jagathsrujan/pj45-pulsejet/cad/PJ-4.5_head-detail.png

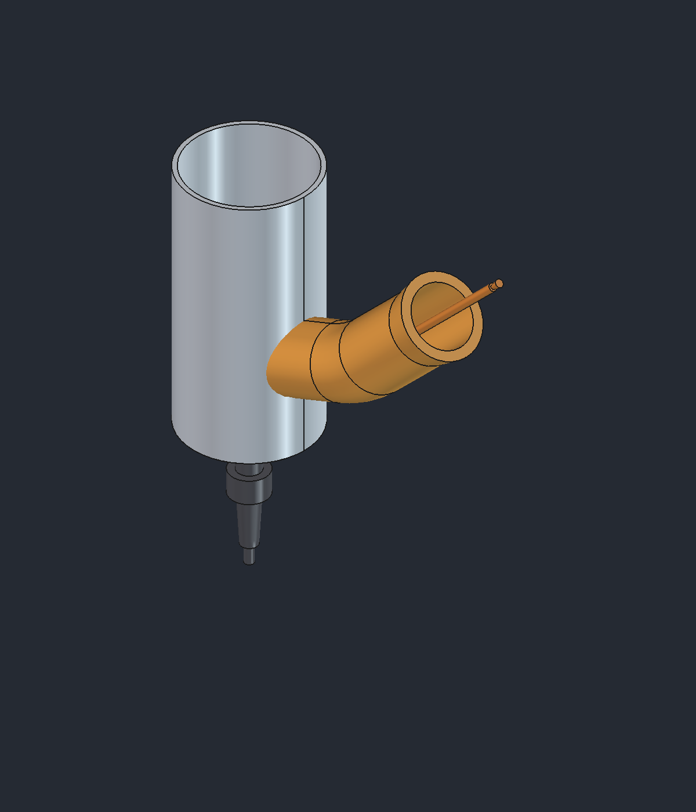
cad/PJ-4.5_head-detail.png
