jagathsrujan/pj45-pulsejet/cad/PJ-4.5_iso.png

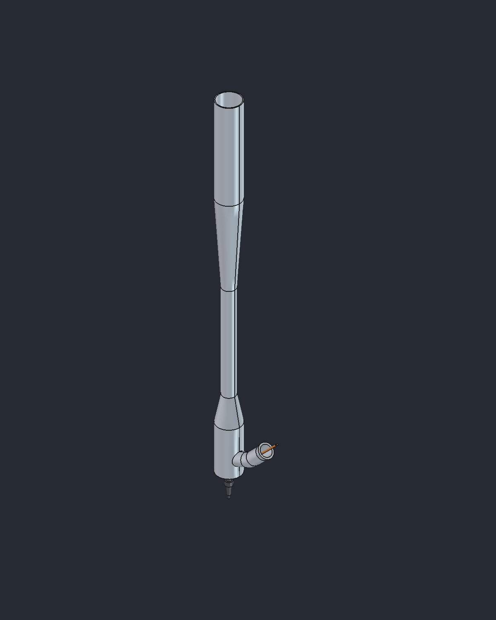
cad/PJ-4.5_iso.png
