jagathsrujan/pj45-pulsejet/cad/PJ-4.5_section-rear.png

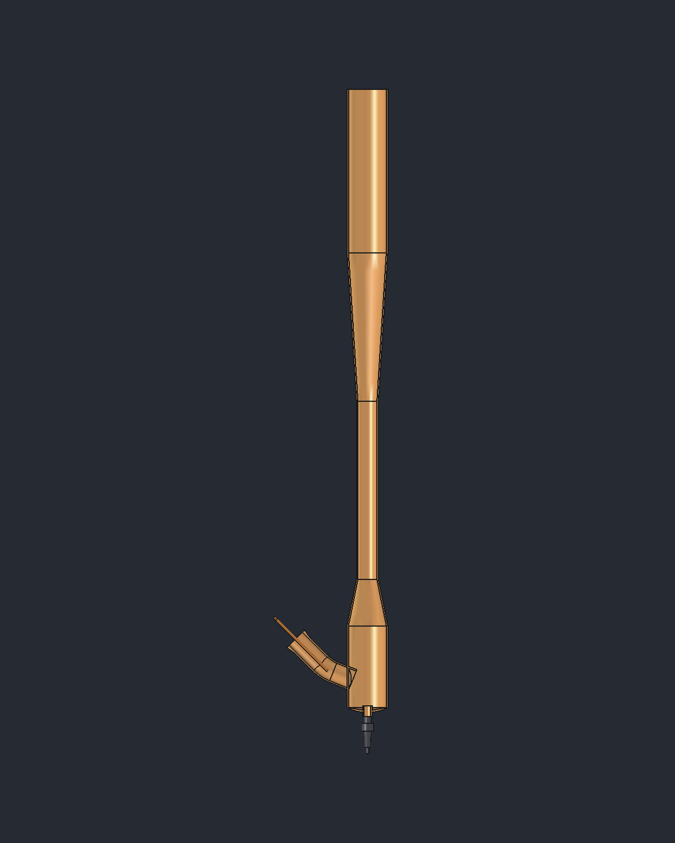
cad/PJ-4.5_section-rear.png
