jagathsrujan/pj45-pulsejet/cad/PJ-4.5_side.png

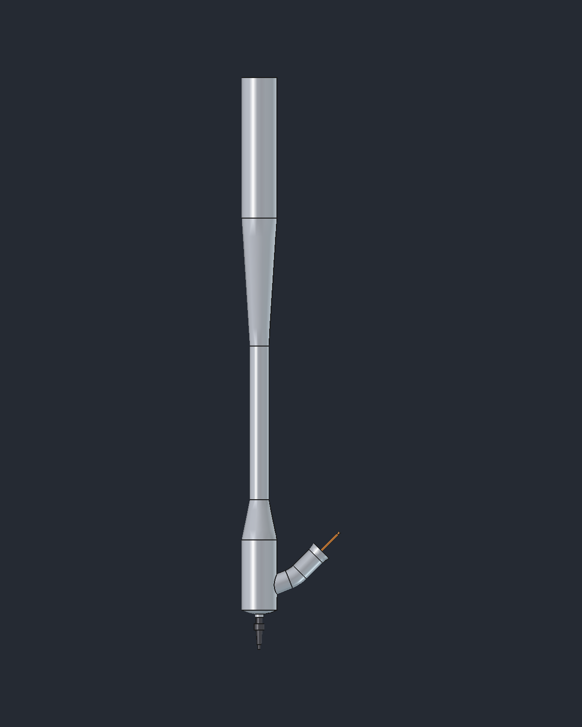
cad/PJ-4.5_side.png
