jagathsrujan/pj45-pulsejet/build/BOM-INDIA.md

# PJ-4.5 Pulse Jet — Bill of Materials (India) — **Hybrid Build**

**Configuration:** reusable metal hot sections + reprintable printed cones/intake, **zero welding** (threaded pipe stack + printed couplers).
**Guides:** `printed-test/HYBRID-TEST-GUIDE.md` (assembly + shopping list) · `cad/CAD-NOTES.md` (geometry) · STLs in `printed-test/HJ_01…05`.
**Currency:** ₹ INR · indicative prices checked Oct 2026 · verify locally (±30%) · 🟢 core · 🟡 to run · ⚪ recommended

---

## A. Engine — metal sections (reusable forever, no welding) 🟢

| # | Item | Spec | Qty | Est. ₹ | Where |
|---|---|---|---|---|---|
| A1 | Chamber tube | 2″ BSP SS304 threaded pipe nipple, 150 mm (2″×6″) | 1 | 300–500 | local pipe/plumbing market |
| A2 | Chamber head | 2″ BSP SS304 coupling (socket) | 1 | 200–300 | same |
| A3 | Head bushing | 2″×½″ BSP SS304 hex reducing bushing | 1 | 120–200 | same |
| A4 | **Plug boss** | ½″ BSP SS304 hex plug — drill Ø9, tap M10×1 | 1 | 80–150 | same (uses tap I2) |
| A5 | Centre pipe | Ø30×1.5 mm SS304 tube, ~245 mm | 1 | 150–250 | steel market |
| A6 | Exhaust pipe | 2″ NB SS304 pipe Sch-10S (Sch-5S ok), ~220 mm | 1 | 250–400 | steel market offcut |
| A7 | Copper washers | ½″ + M10 sizes | 4 | ~30 | hardware |
| | **Subtotal A** | | | **~₹1,150–1,850** | reusable |

*Buy BSP (Indian standard) thread fittings in SS304 and test-fit threads at the shop. Alternative head: 2″ SS cap + Ø9.5 drill + M10×1 tap + thin M10×1 jam nut inside.*

## B. Engine — printed sections (consumables) 🟢

| # | Item | Spec | Qty | Est. ₹ | Where |
|---|---|---|---|---|---|
| B1 | Filament — working | **Numakers/WOL3D ABS ~₹710–900/kg** (budget) or **eSun ASA ~₹1,950/kg** (better) | 1 kg | 710–1,950 | ideal3d.in, Zbotic, Amazon.in |
| B2 | Filament — mockup | PLA 1 kg (fit-check prints first) | 1 | ~700 | Amazon.in |
| B3 | Printed set | `HJ_01` nozzle cone · `HJ_02` exhaust cone · `HJ_03` intake · `HJ_04` C1 couplers ×2 · `HJ_05` C2 couplers ×2 | 1 set | — | free STLs (print yourself, H2D) |
| | **Subtotal B** | | | **~₹1,400–2,650** | covers many reprints |

**Full set = 220 g** → **₹160 (ABS) / ₹430 (ASA) per reprint** — your only recurring cost.

## C. Assembly & sealing consumables 🟢

| # | Item | Spec | Qty | Est. ₹ | Where |
|---|---|---|---|---|---|
| C1 | Furnace/ceramic cement | 1000 °C+ class (not epoxy/RTV) | 1 kg | 150–350 | hardware / IndiaMART (refractory supplier) |
| C2 | Sodium silicate (water-glass) | bore coating for printed cones | 500 ml | ~100 | hardware/chemical shop |
| C3 | Ceramic fiber (kaowool) tape or blanket | wrap nozzle cone | 1 roll/small piece | 300–500 | IndiaMART / refractory shop |
| C4 | Fiberglass tape | 25 mm, intake root wrap | 1 roll | 100–150 | hardware |
| C5 | M3×8 self-tapping screws + washers | couple joints (pilot holes are printed in) | 20 | ~80 | hardware |
| C6 | PTFE tape + wire brush + sandpaper | thread sealing / cleanup | 1 set | ~80 | hardware |
| | **Subtotal C** | | | **~₹800–1,250** | |

## D. Fuel system (propane) 🟡

| # | Item | Spec | Qty | Est. ₹ | Where |
|---|---|---|---|---|---|
| D1 | LPG cylinder | 14.2 kg domestic (refill) or 5 kg | 1 refill | 600–900 | local gas agency |
| D2 | High-pressure LPG hose | steel-wire braided, 1.5–2 m | 1 | ~345 | Amazon.in / gas shop |
| D3 | Cylinder→hose adapter (no regulator) | brass burner-pipe adapter | 1 | 250–500 | gas/burner shop |
| D4 | **Needle valve (metering)** | brass ¼″ BSP, gas-rated | 1 | 400–1,200 | Amazon.in / IndiaMART |
| D5 | **Ball valve (kill switch)** | brass ¼″ gas ball valve | 1 | 150–400 | hardware / Amazon |
| D6 | Tee + nipples + hose clamps | brass ¼″, 4 clamps | 1 set | ~250 | hardware |
| D7 | Injector tube | 1/8″ (3.2 mm) copper/SS tube, ~300 mm ×2 | 2 | ~150 | refrigeration/AC spares shop |
| | **Subtotal D** | | | **~₹1,500–3,000** | |

## E. Ignition 🟡

| # | Item | Spec | Qty | Est. ₹ | Where |
|---|---|---|---|---|---|
| E1 | Spark plug | NGK CM-6 (M10×1) | 1 | 1,699 (Fortune India) | drone/RC shops, Amazon.in |
| E1′ | *(budget alt)* | generic M10×1 RC plug | 1 | 400–800 | Amazon.in |
| E2 | HT lead + plug cap | copper-core + silicone boot | 1 | ~200 | auto-electrical |
| E3 | HV boost module | DC 6–12 V → 15–20 kV spark module | 1 | 250–400 | Robu.in |
| E4 | Battery | 12 V SLA 1.3–4 Ah (or borrow) | 1 | 450–800 | battery shop |
| E5 | Ground strap + lugs + switch + wire | 4 mm² | 1 set | ~200 | hardware |
| | **Subtotal E** | | | **~₹1,900–3,700** | |

## F. Starting air 🟡

| # | Item | Spec | Qty | Est. ₹ | Where |
|---|---|---|---|---|---|
| F1 | Leaf blower (or borrow) | big volume, low speed | 1 | 1,800–2,600 | Amazon.in / local |
| F2 | Firework sparklers | backup continuous ignition | 1 pack | ~50 | fireworks shop (licensed) |
| | **Subtotal F** | | | **~₹50–2,650** | |

## G. Test stand & instrumentation ⚪

| # | Item | Spec | Qty | Est. ₹ | Where |
|---|---|---|---|---|---|
| G1 | Base plate | MS 6 mm, ~300×400 | 1 | ~400 | steel market |
| G2 | Rails/angles + bolts | MS flat/angle ~1 m + M6/M8 set | 1 set | ~500 | steel market |
| G3 | Load cell + HX711 | 50 kg bar + amplifier | 1 | 400–600 | Robu.in / Robocraze |
| G4 | Arduino Nano *(optional)* + K-thermocouple/MAX6675 *(optional)* | logging | 1 set | 400–700 | Robu.in |
| | **Subtotal G** | | | **~₹900–2,200** | |

## H. Safety gear ⚪ (non-negotiable)

| # | Item | Qty | Est. ₹ |
|---|---|---|---|
| H1 | Ear muffs NRR30 + ear plugs (double protection) | 2 sets | 1,200 |
| H2 | Face shield / goggles | 2 | 450 |
| H3 | Leather gloves | 2 pairs | 500 |
| H4 | Fire extinguisher ABC 2 kg (CO2 2 kg ~₹3–4k) | 1 | 1,500–2,000 |
| | **Subtotal H** | | **~₹3,700–4,200** |

## I. Tools & consumables ⚪ (check college workshop first)

| # | Item | Spec | Qty | Est. ₹ |
|---|---|---|---|---|
| I1 | Electric drill + bits | Ø9.0 mm (tap drill) + pilot set | 1 set | 400 (or college) |
| I2 | **M10×1 tap + tap wrench** | for the plug boss | 1 | 350 |
| I3 | Hacksaw + blades, files, hammer, clamps, punches, angle grinder + discs | — | set | 800–2,800 |
| | **Subtotal I** | | | **~₹800–2,800** |

**No welding anywhere** — the previous TIG-weld service (₹500–1,500) and rolled-cone sheet metal are eliminated.

---

## Cost roll-up (indicative)

| Package | Est. ₹ |
|---|---|
| **Bare running hybrid rig** (A + one ABS spool + C + D + E + sparklers; borrowing cylinder/blower/tools/battery) | **~₹6,100–10,600** |
| + starting-air blower (F) | +1,800–2,600 |
| + test stand & data logging (G) | +900–2,200 |
| + safety kit (H) | +3,700–4,200 |
| **Full package, all new** | **~₹12,500–19,500** (₹22,400 if also buying tools) |
| **Recurring:** full printed reprint set | **₹160 (ABS) / ₹430 (ASA)** |
| Never repeat: metal sections, sealing tools | ₹0 |

*Upgrading to ASA instead of ABS adds ~₹1,200 once; if you want the best filament later, PPS-CF is ~₹4,000–5,500/kg but the metal sections already carry the heat — not needed.*

## Sourcing guide

- **Pipe/plumbing market:** A1–A4 threaded BSP fittings (SS304), copper washers — bring the shopping list and test-fit threads.
- **Steel market:** A5 (Ø30×1.5 tube), A6 (2″ pipe offcut), G1–G2 (MS plate/rails).
- **Refractory/IndiaMART:** furnace cement, kaowool, sodium silicate.
- **Electronics (Robu.in / Robocraze / Amazon.in):** HV module, load cell + HX711, Arduino, thermocouple.
- **Drone/RC shops:** NGK CM-6 (Fortune India ₹1,699; generics ₹400–800).
- **Gas agency/burner shop:** hose, adapter, valves.
- **3D printing:** your H2D — ABS/ASA (see `HYBRID-TEST-GUIDE.md` §3 for settings).

## Open items — verify before buying

1. **Thread standard:** confirm BSP (G) fittings; some import shops sell NPT — don't mix.
2. **Plug reach:** with boss + bushing stacked, check the CM-6 tip protrudes ~2–3 mm into the chamber and doesn't foul anything.
3. **Coupler fit test:** print one C1 and one C2 first; adjust +0.5 % X/Y if ABS/ASA shrinkage makes them tight.
4. **Filament pick:** ABS (~₹710) vs ASA (~₹1,950) — ASA prints the tall cones more easily.
5. **Cylinder policy:** confirm campus rules for LPG testing (outdoors, long hose).

---

## Appendix — later upgrade to full metal (delta only)

When you're done iterating, the printed cones/intake can be replaced by the welded metal version: SS304 sheet 2 mm (~₹350) for both cones + TIG weld service (₹500–1,500) + ER308L filler (~₹300), per `cad/CAD-NOTES.md`. Everything else in this BOM (A, C–I) carries over — the metal stack re-threads onto the welded body unchanged.
