jagathsrujan/pj45-pulsejet/cad/PJ-4.5.step

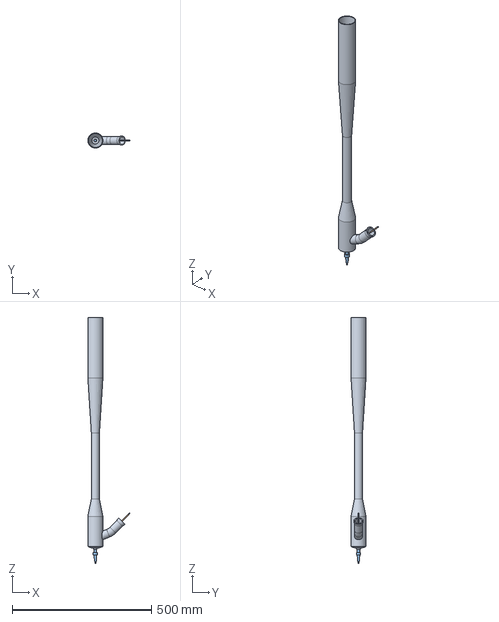
[picture p5: CAD file, 2026-10-01]
cad/PJ-4.5.step
151.8 x 54.2 x 882.5 mm
