jagathsrujan/pj45-pulsejet/printed-test/HJ_02_exhaust-cone.stl

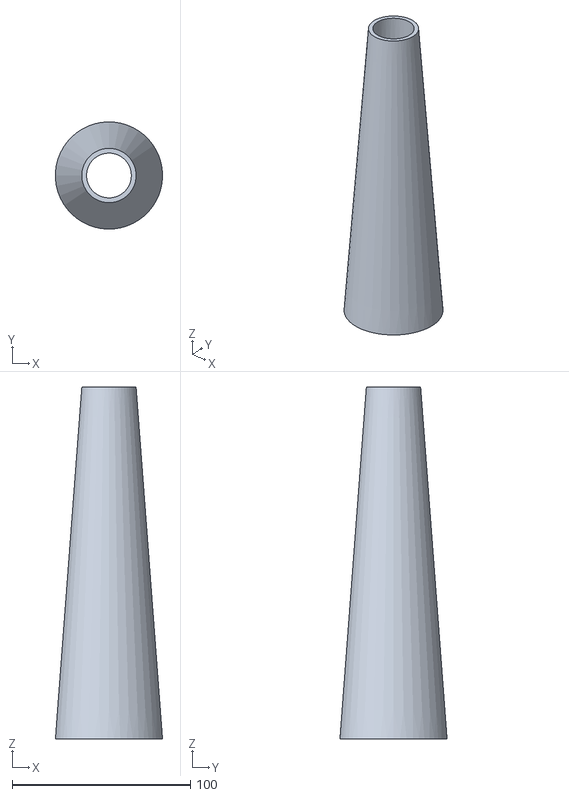
[picture p6: CAD file, 2026-10-01]
printed-test/HJ_02_exhaust-cone.stl
60.1 x 60.2 x 197.6
