jagathsrujan/pj45-pulsejet/printed-test/HJ_04_coupler-C1-60mm_x2.stl

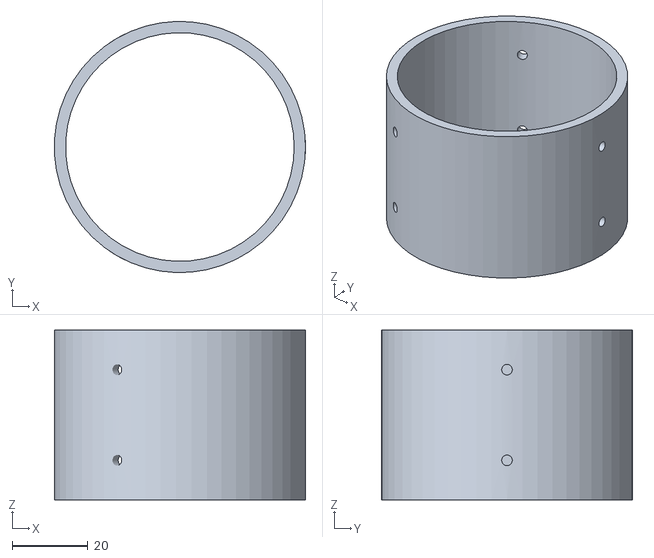
[picture p7: CAD file, 2026-10-01]
printed-test/HJ_04_coupler-C1-60mm_x2.stl
66.5 x 66.5 x 45.0
