jagathsrujan/pj45-pulsejet/printed-test/HJ_03_intake.stl

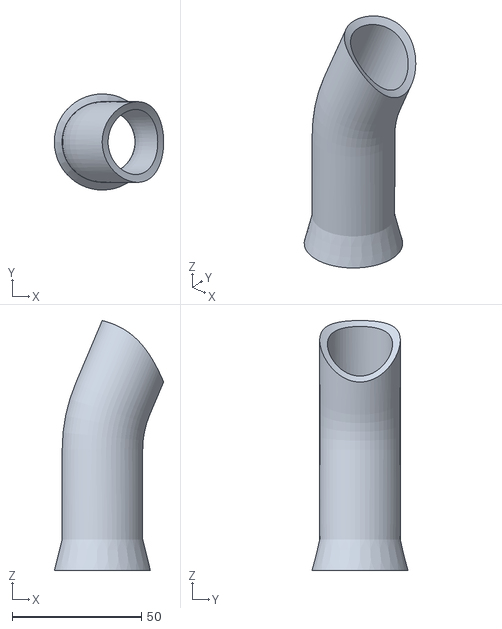
[picture p8: CAD file, 2026-10-01]
printed-test/HJ_03_intake.stl
42.2 x 37.1 x 96.5
