jagathsrujan/pj45-pulsejet/printed-test/PJ-4.5-HYBRID.FCStd

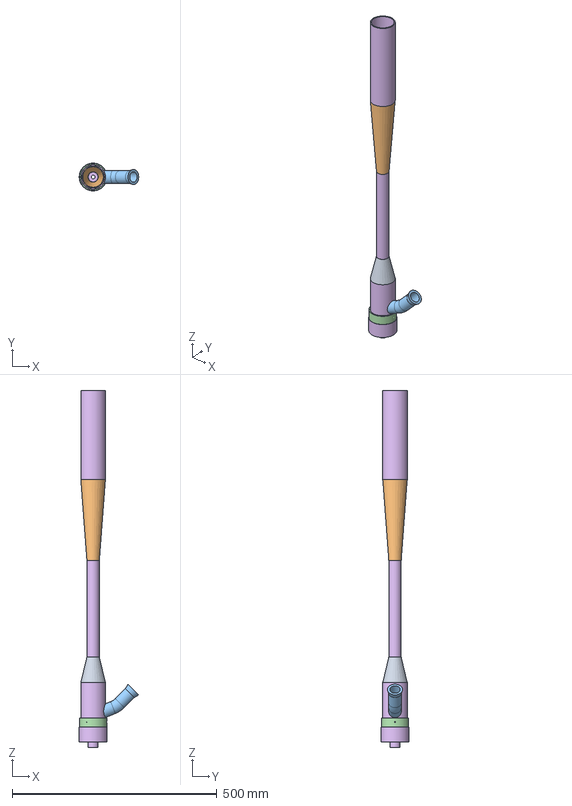
[picture p9: CAD file, 2026-10-01]
printed-test/PJ-4.5-HYBRID.FCStd
145.4 x 68.0 x 871.5 mm
HJ_nozzle_cone
HJ_exhaust_cone
HJ_intake
HJ_coupler_C1_60mm_x2
HJ_coupler_C2_30mm_x2
HJ_METAL_stand_in
