jagathsrujan/pj45-pulsejet/printed-test/HJ_05_coupler-C2-30mm_x2.stl

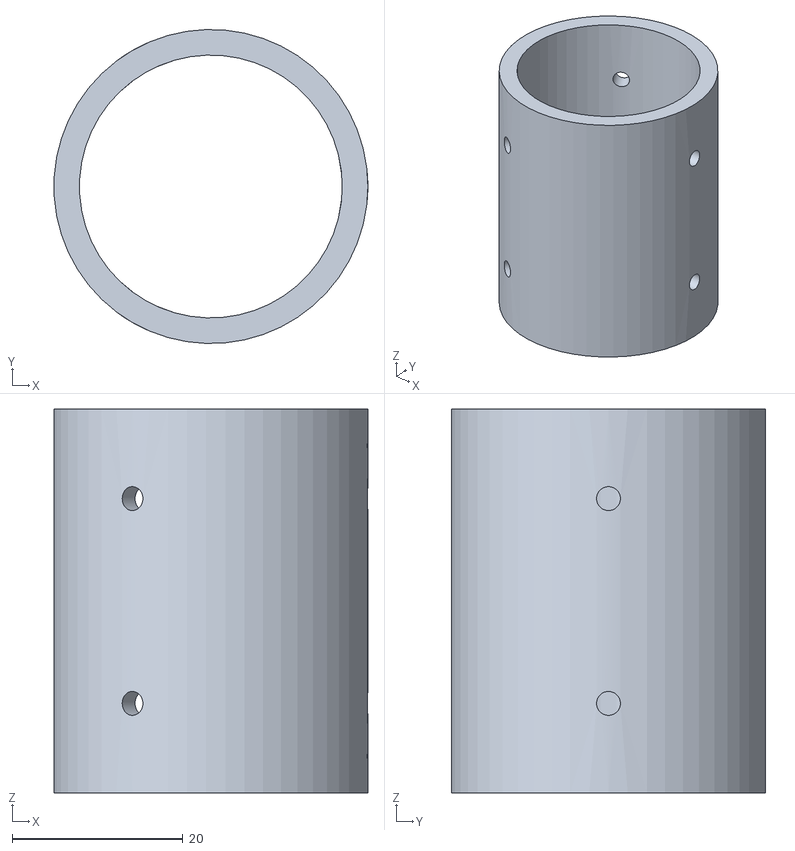
[picture p10: CAD file, 2026-10-01]
printed-test/HJ_05_coupler-C2-30mm_x2.stl
36.8 x 36.8 x 45.0
