jagathsrujan/pj45-pulsejet/printed-test/HJ_01_nozzle-cone.stl

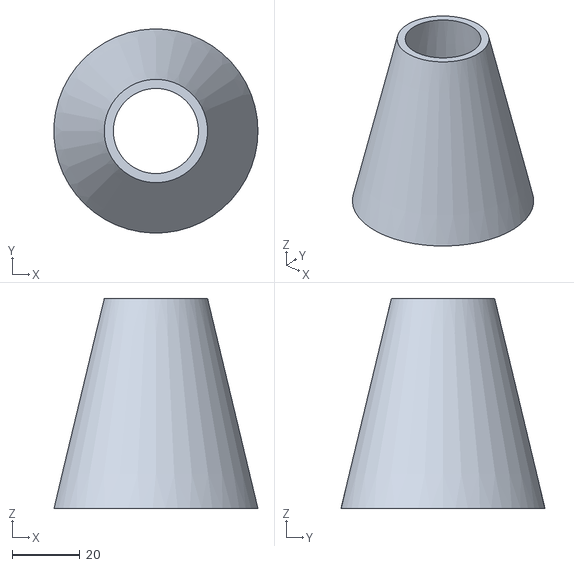
[picture p11: CAD file, 2026-10-01]
printed-test/HJ_01_nozzle-cone.stl
60.2 x 60.2 x 62.0
