jagathsrujan/pj45-pulsejet/(list of files, cad)

Other CAD files:
cad/PJ-4.5.FCStd
cad/PJ-4.5.stl
